asuperidea/Isaac-The-Carpentopod/README.md

# Isaac The Carpentopod

Isaac The Carpentopod is a walking robot that uses [Giliam de Carpentier's *Carpentopod* Linkage](https://www.decarpentier.nl/carpentopod). Isaac's body is fully 3D printed in PLA, his brain is an **Arduinio mega** paired with an **L298N dual motor driver** that powers both of Isaac's **Gearbox DC Motors**.

[**ASSEMBLY GUIDE**](Guide/README.md)

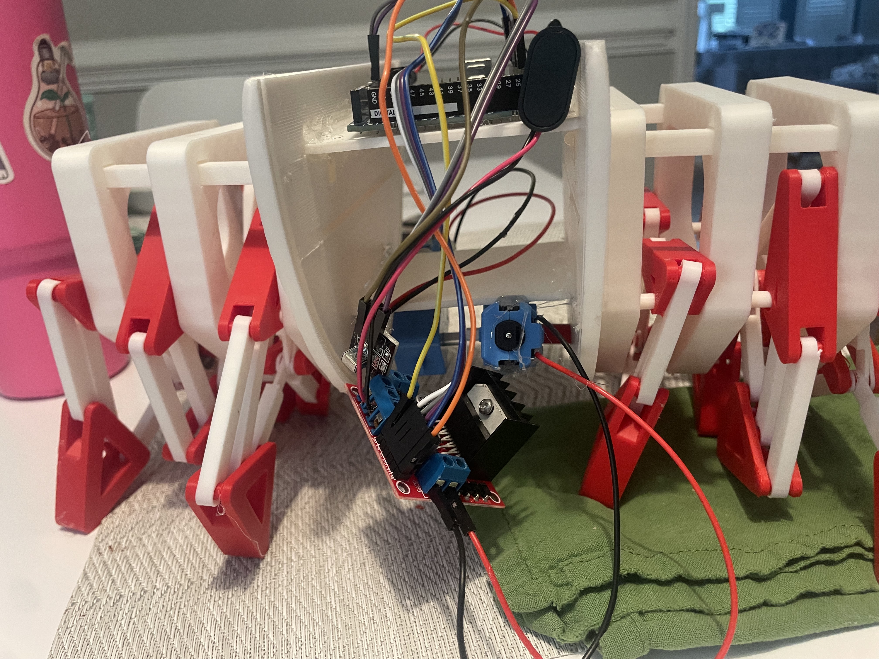
[picture p1: Images/IMG_3768.jpeg]
Image of Issac


# Story

## Design
Isaac was designed in [OnShape](https://cad.onshape.com/documents/fd8d649ce3643e24ce6086ff/w/2fd19f425c5ef16a61c62a1e/e/ff1b6042f026958810a4dbde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) using the ratios Giliam de Carpentier used in his [Walking Table](https://www.decarpentier.nl/carpentopod). These rations were generated by Giliam using software that eveloved thousands of leg generations until it found an ideal linkage. Giliam was inspried by [Jansen's linkage](https://en.wikipedia.org/wiki/Jansen%27s_linkage), a similar linkage designed by kinetic sculptor Theo Jansen for his [*Strandbeest*](https://en.wikipedia.org/wiki/Theo_Jansen#The_strandbeest).

Isaac is split into three thirds: the outer two sections house three leg linkages each, while the central section holds the electronics. The leg sections use backplates for each linkage, the backplates keep the legs in place while being attached on beams that run to the central section. The central section has four levels sandwhiched between two large plates, these levels contain the electronics.

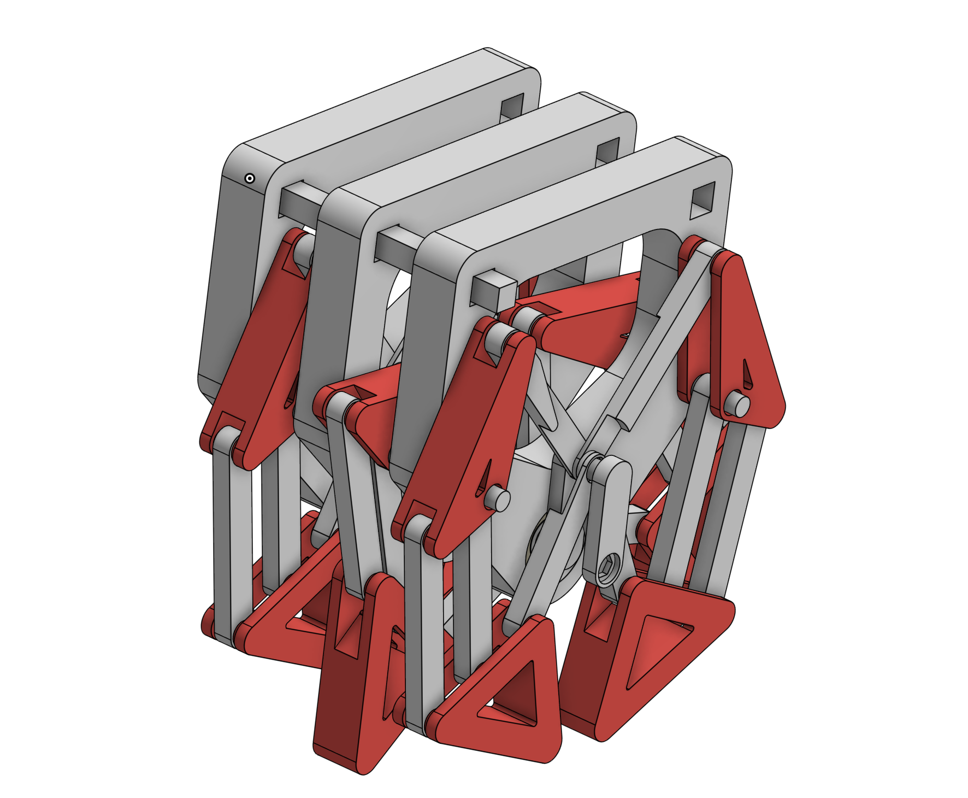
[picture p2: Images/issaclegs.png]
Isaacs Leg In Assembly

Wiring Diagram

## Printing
The 3D printing process took around 4 days of on and off printing. During this time I used an estimated 700 grams of filament (PLA). To avoid glue, I would pause prints and insert parts into them, allowing for moving parts that are still kept together. Later in the process I printed the central portions of the robot. Some parts did require [PLA glue](https://www.amazon.com/Printer-Super-Glue-Gel-Heat-Resistant/dp/B0CBSGWZRW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) to attach together. While building I also broke some parts, requiring make-up prints. ***If you would like to 3d print these parts yourself, please see the [3D Files Folder](/3D%20Files/)***.

## Building and Iteration
While Isaac was mostly built as designed, some things were changed or adapted during the process. For example I switched from hot glue to PLA glue. Another notable change was the introduction of gears to provide more torque. These changes helped make Isaac much better.

## Hackclub
Isaac was built for the [Hackclub](https://hackclub.com/) program [Macondo](https://macondo.hackclub.com/). For previous projects, Hackclub provided me with funding and an amazing community. You can see [**Isaac on Hackclub here**](https://macondo.hackclub.com/projects/7520).

Isaac was moved to [Hackclub Forge](https://forge.hackclub.com/) in October of 2026. [Isaac on Forge](https://forge.hackclub.com/projects/4168)

## Watch Isaac
See the following linsk to watch Isaac move!
- https://youtube.com/shorts/_IkzzDk3RVs 
- https://youtube.com/shorts/l0Tr8de97ck 
- https://youtube.com/shorts/lmN1PoIx2i8 
- https://youtu.be/W7OBL0XSNqM 
- https://youtube.com/shorts/VChF0OOxuyg 

# Bill of Materials
* A star Indicates somthing I already had before starting this project*

| Item | Quantity | Price | Full Price | URL | Note |
| --- | -- | ----- | --- | ---| --- |
| DC Motors | 2 | $2.50 | $9.99 (4x) | | DC Motors | 2 | $1.74 | $6.99 (4x) | https://www.amazon.com/BOJACK-Pcs-Type-130-EK1450/dp/B09FPXF1QK | Other DC motors may work |
| *Arduino MEGA | 1 | $22.99 | $22.99 | https://www.amazon.com/ELEGOO-Compatible-Arduino-Projects-Compliant/dp/B01H4ZLZLQ | Other vendors avalible |
| L298N Motor Driver | 1 | $3.45 | $6.90 | https://www.amazon.com/WWZMDiB-L298N-H-Bridge-Controller-Raspberry/dp/B0CR6BX5QL | Other vendors avalible, Only one Needed |
| *IR Remote + Reviever | 1 | $2.66 | $7.99 | https://www.amazon.com/HiLetgo-HX1838-Infrared-Wireless-Control/dp/B01HTC5JX4/ | Any Receiver/Remote that can work w/ arduino works, Only One Needed |
| *PLA Glue | 1 | $12.99 | $12.99 | https://www.amazon.com/Printer-Super-Glue-Gel-Heat-Resistant/dp/B0CBSGWZRW/ | 1.76 Oz, what I used for this project |
| Rechargeable Battieres | 2 | $3.24 | $12.99 | https://www.amazon.com/dp/B0FRMWGPD2 | 2 Minimum, 4 recomended |
| Battery Clip DC Plug | 2 | ~$2 | $3.99 | https://www.amazon.com/dp/B0D9VT2FMF | 2 Minimum, More recomended in case they break |

**See [BOM in CSV](/Misc/BOM.csv) for CSV Bill of Materials**
**See [Wiring Diagram](/Misc/Circuit%20Image%20from%20Cirkit%20Designer.svg) For Wiring**

# Repo Guide

[3D Files](/3D%20Files/) Contains all the files used here, they are also in the [OnShape](https://cad.onshape.com/documents/fd8d649ce3643e24ce6086ff/w/2fd19f425c5ef16a61c62a1e/e/35f5cd3640a624cc9189c34f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). All files are .stl with "STEPS Files" folders containing .STEP.
[Software](/Software/) Contains all the code that the arduino runs
[Journals](/Journals/) Contains every Hackclub journal entry I made (markdown files)
[Images](/Images/) Contains images of Isaac
[Guide](/Guide/) Contains BOM, Wiring, and Guide

# About Me
My name is [Simon](https://simoncrystal.dev), I am a rising 10th grader (Class of '29) in North Carolina, United States. I built Isaac to challange myself and to get into Hackclub Macondos Columbia Hackathon, an amazing oppurtunity.


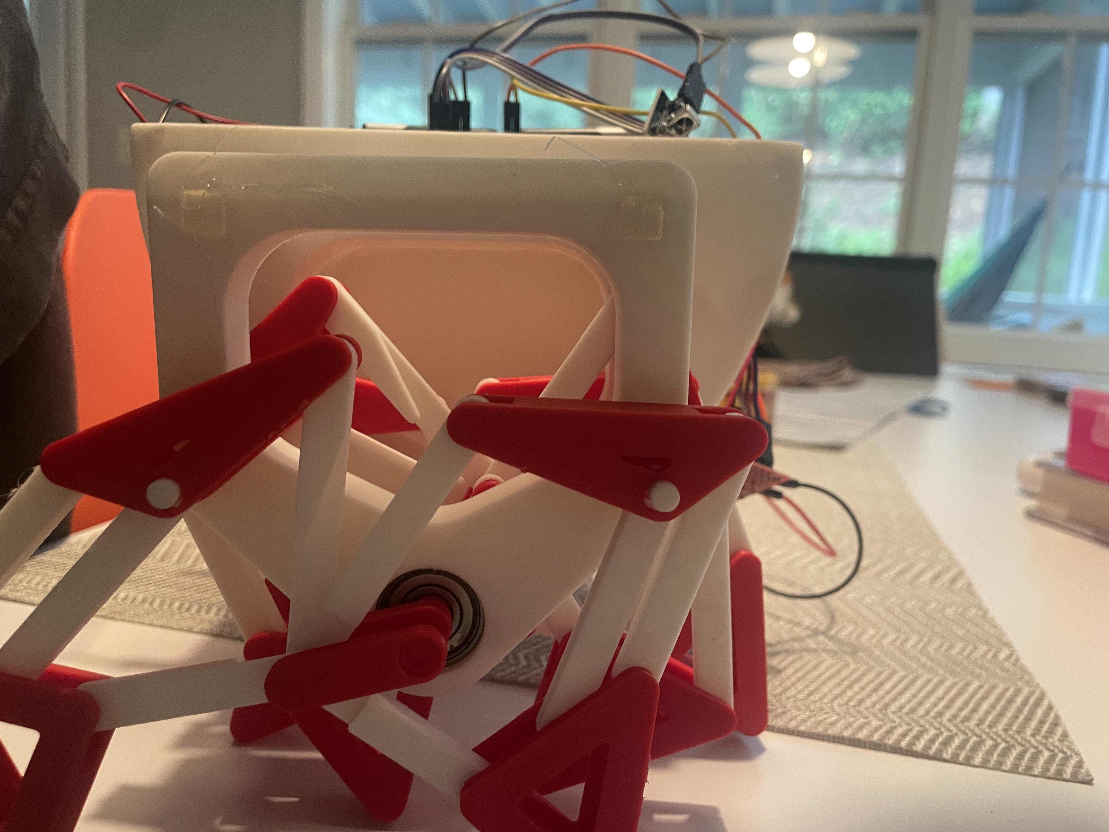
[picture p4: Images/IMG_3765.jpeg]
