asuperidea/Isaac-The-Carpentopod/Images/IMG 3727.jpg

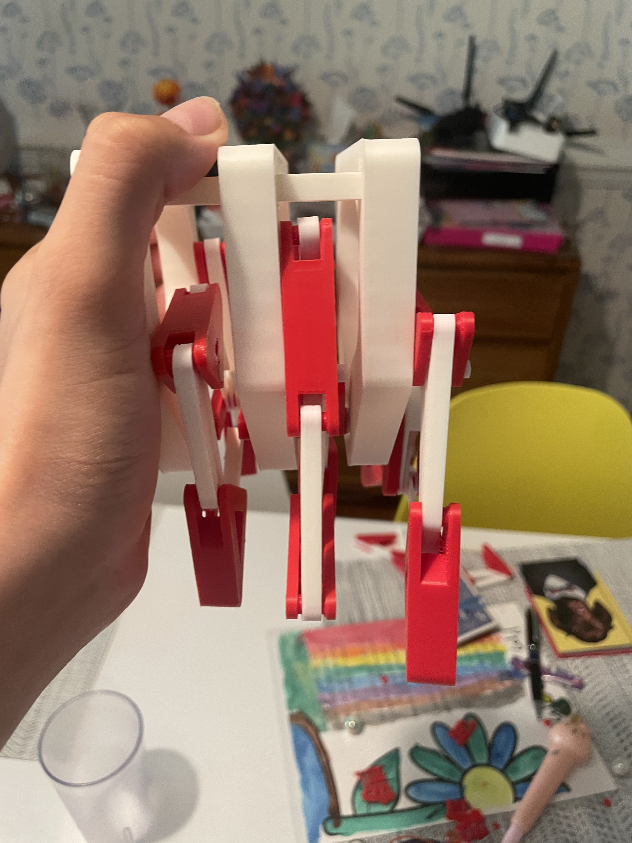
Images/IMG 3727.jpg
