asuperidea/Isaac-The-Carpentopod/Images/issacimage12.webp

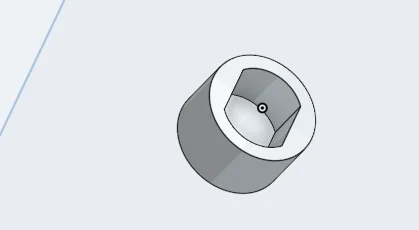
Images/issacimage12.webp
