asuperidea/Isaac-The-Carpentopod/Images/issacimage13.webp

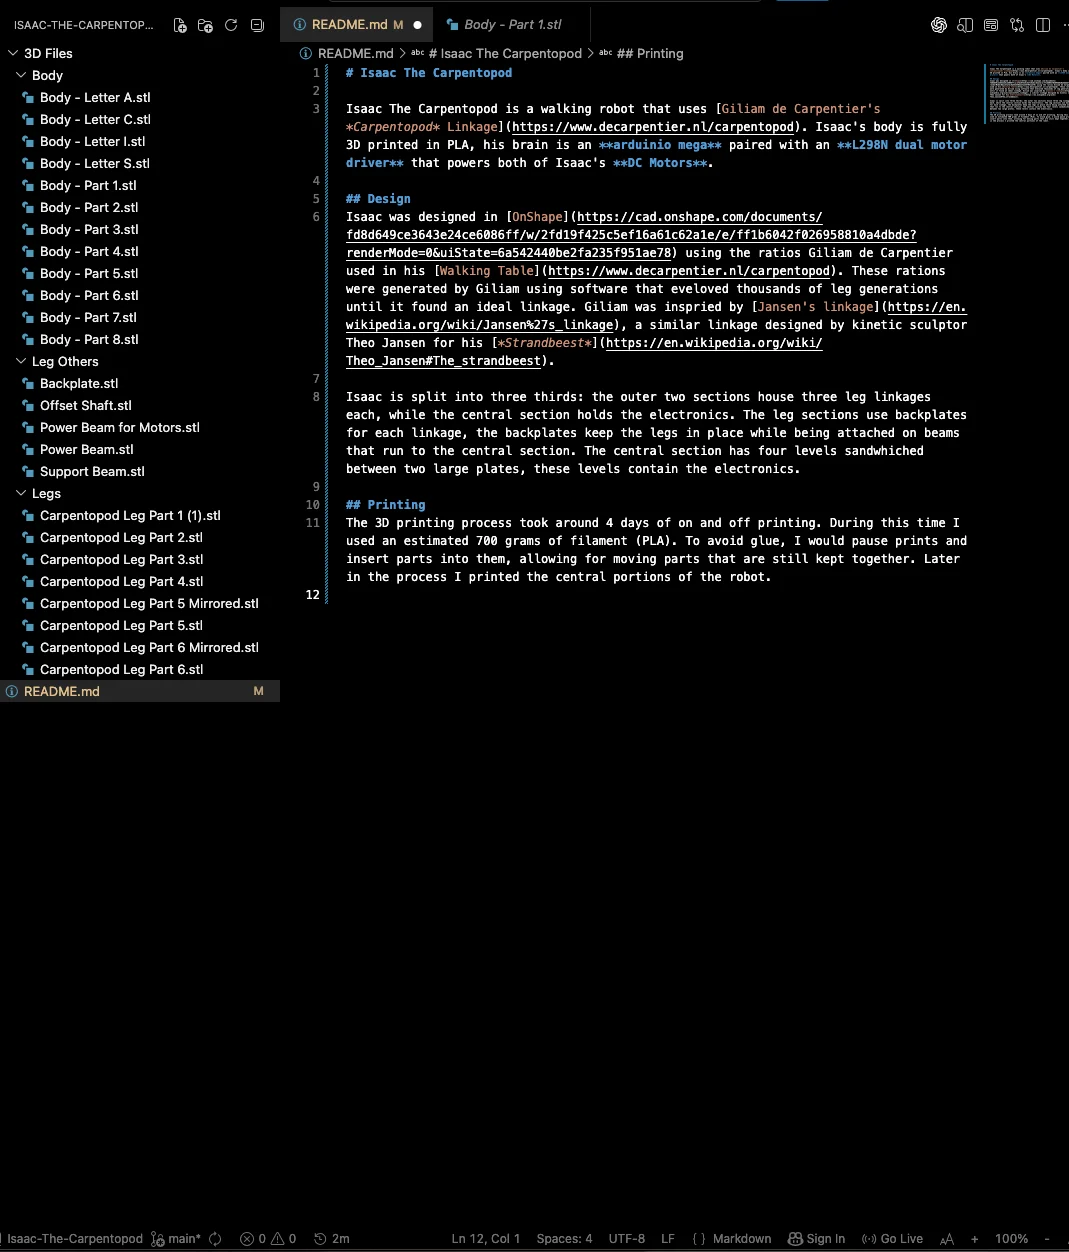
Images/issacimage13.webp
