asuperidea/Isaac-The-Carpentopod/Images/issacimage14.webp

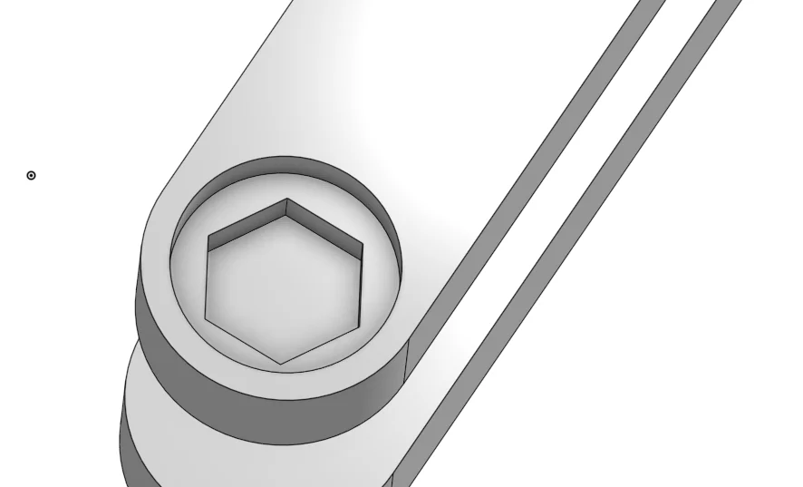
Images/issacimage14.webp
