asuperidea/Isaac-The-Carpentopod/Images/issacimage15.webp

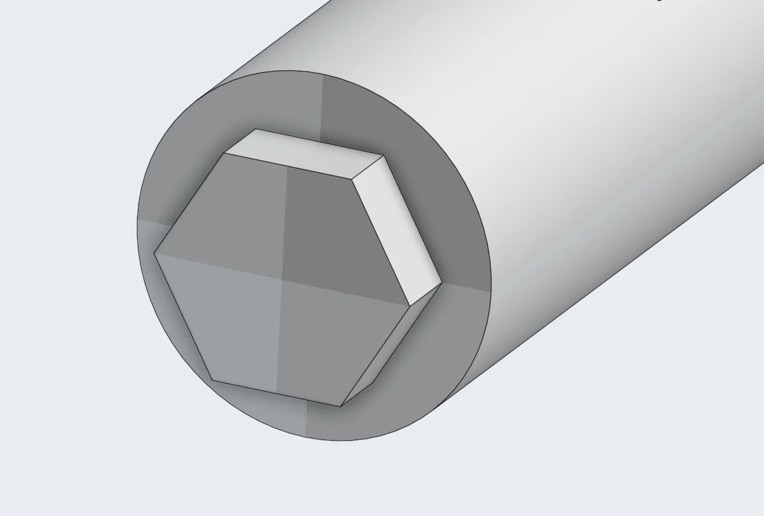
Images/issacimage15.webp
