asuperidea/Isaac-The-Carpentopod/Images/issacimage16.webp

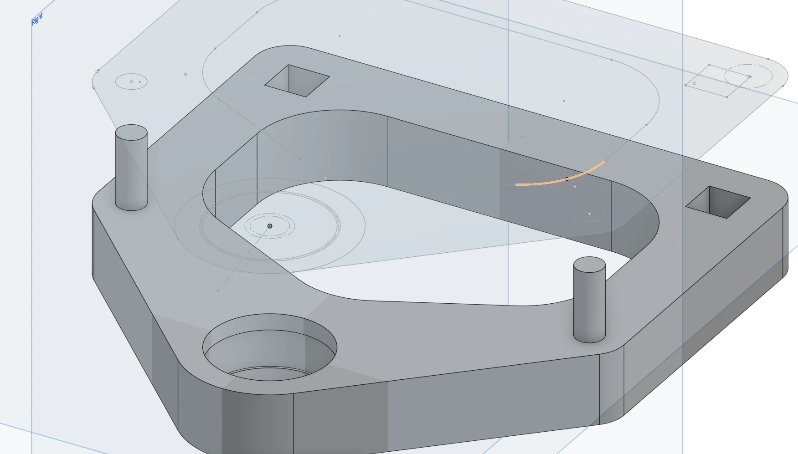
Images/issacimage16.webp
