asuperidea/Isaac-The-Carpentopod/Images/issacimage17.webp

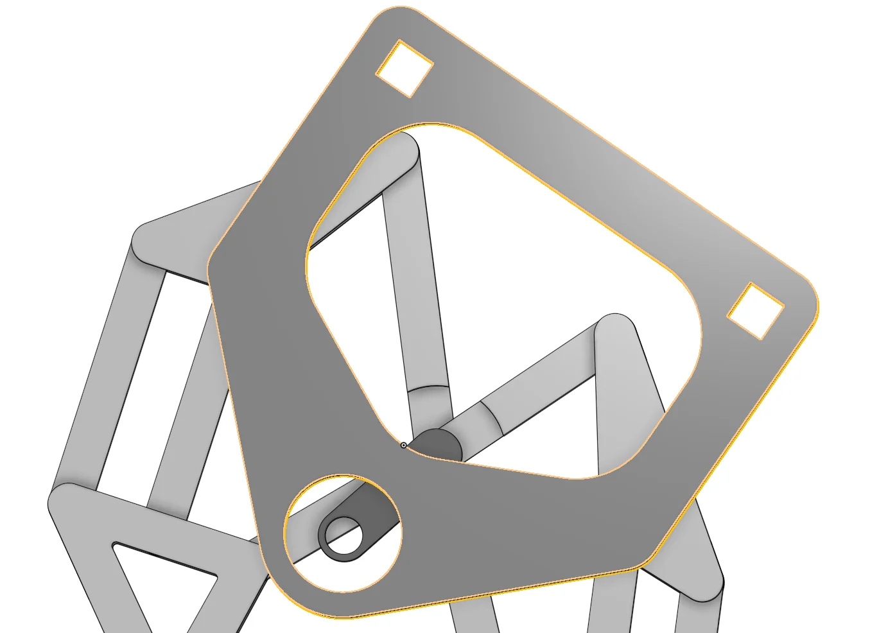
Images/issacimage17.webp
