asuperidea/Isaac-The-Carpentopod/Images/issacimage18.webp

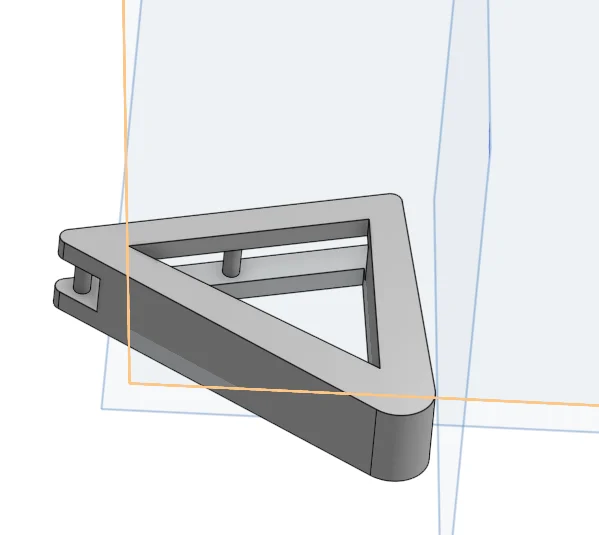
Images/issacimage18.webp
