asuperidea/Isaac-The-Carpentopod/3D Files/Assemblies/Right Leg Assembly.step

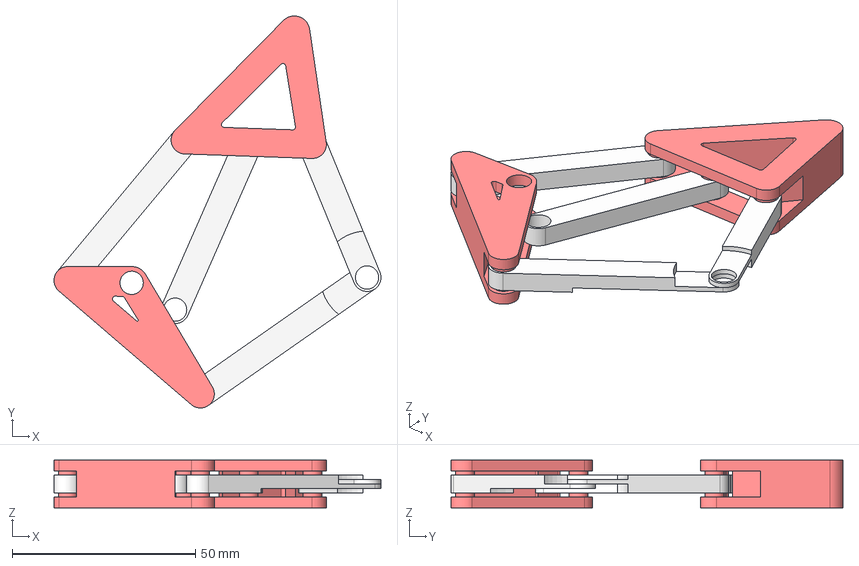
[picture p13: CAD file, 2026-10-01]
3D Files/Assemblies/Right Leg Assembly.step
89.3 x 107.0 x 13.0 mm
