asuperidea/Isaac-The-Carpentopod/3D Files/Assemblies/Left Leg Assembly.step

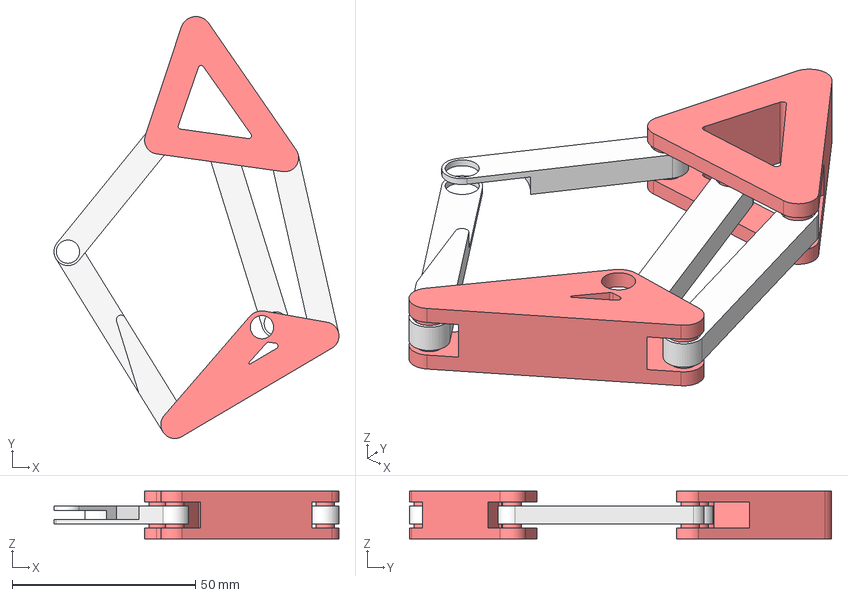
[picture p14: CAD file, 2026-10-01]
3D Files/Assemblies/Left Leg Assembly.step
77.8 x 115.2 x 13.0 mm
