asuperidea/Isaac-The-Carpentopod/3D Files/Assemblies/3x Leg Pair Assembly.step

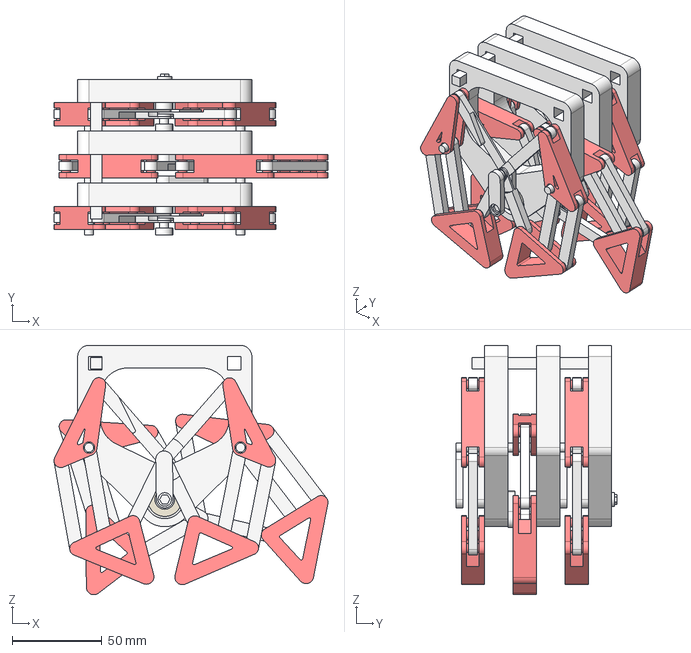
[picture p15: CAD file, 2026-10-01]
3D Files/Assemblies/3x Leg Pair Assembly.step
153.0 x 90.0 x 139.3 mm
8mm ID Bearing (22mm OD, 7mm WD, Shielded) x 3
