asuperidea/Isaac-The-Carpentopod/3D Files/Assemblies/Leg W- Backplate Assembly.step

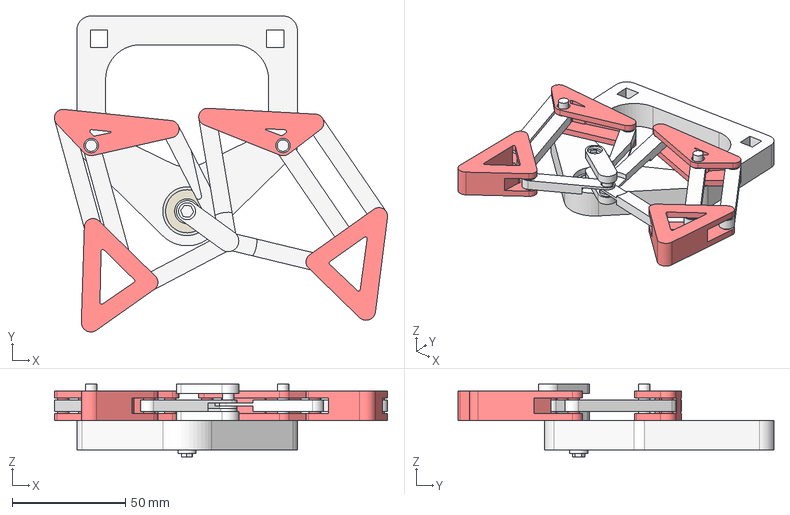
[picture p16: CAD file, 2026-10-01]
3D Files/Assemblies/Leg W- Backplate Assembly.step
146.9 x 139.4 x 32.0 mm
8mm ID Bearing (22mm OD, 7mm WD, Shielded)
