asuperidea/Isaac-The-Carpentopod/3D Files/Body/Basic Body/STEP Files/Body - Main Plate.step

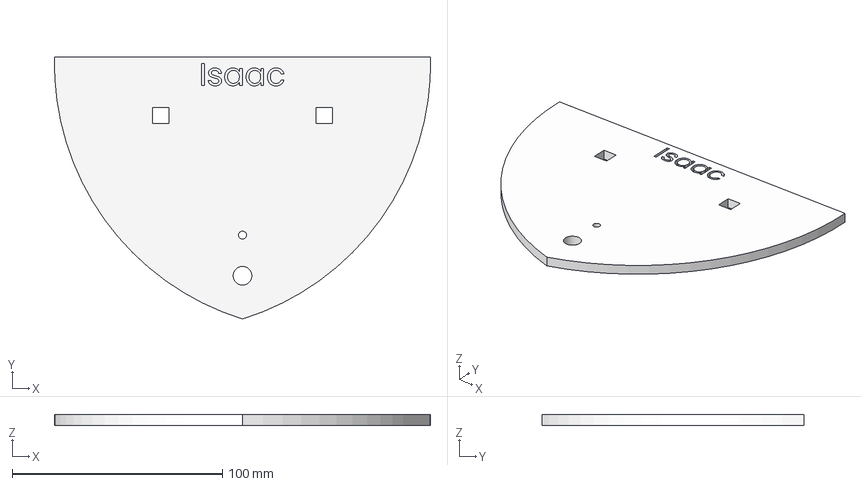
[picture p17: CAD file, 2026-08-03]
3D Files/Body/Basic Body/STEP Files/Body - Main Plate.step
178.7 x 124.5 x 5.00 mm
