asuperidea/Isaac-The-Carpentopod/3D Files/Body/Basic Body/STEP Files/Body - Part 5.step

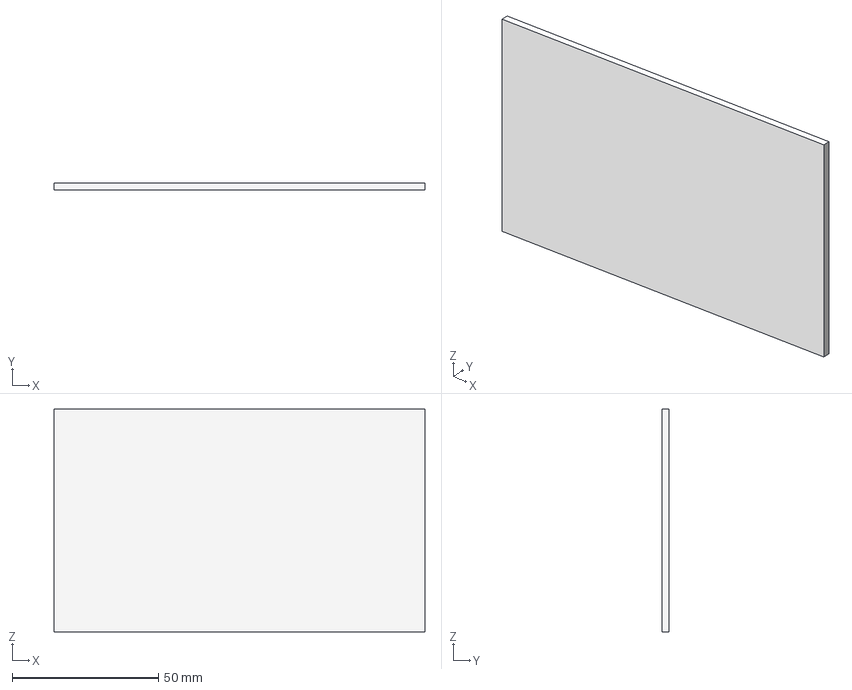
[picture p18: CAD file, 2026-08-03]
3D Files/Body/Basic Body/STEP Files/Body - Part 5.step
127.0 x 2.54 x 76.2 mm
