asuperidea/Isaac-The-Carpentopod/3D Files/Body/Gears/Body - Spur gear (8 teeth).stl

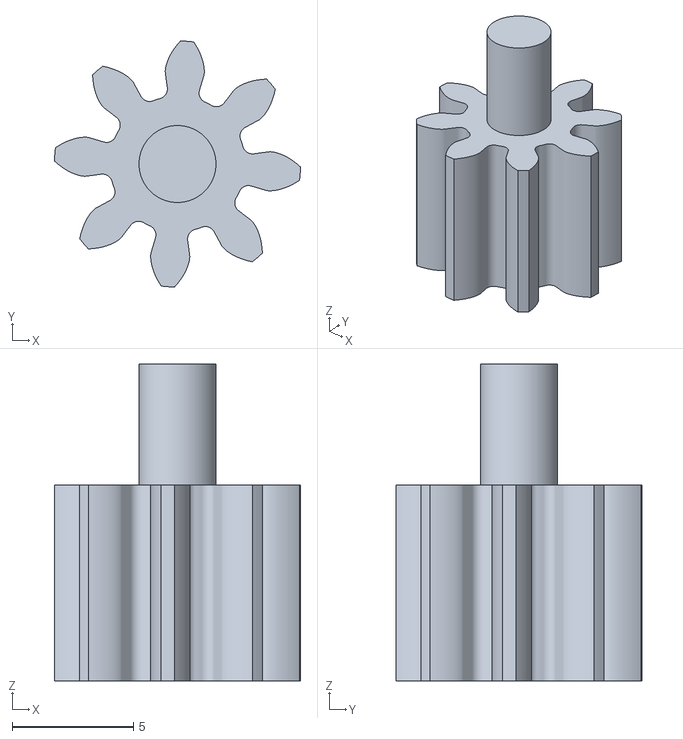
[picture p19: CAD file, 2026-08-02]
3D Files/Body/Gears/Body - Spur gear (8 teeth).stl
10.2 x 10.2 x 13.1
