asuperidea/Isaac-The-Carpentopod/3D Files/Body/Letters/STEP Files/Body - Letter S.step

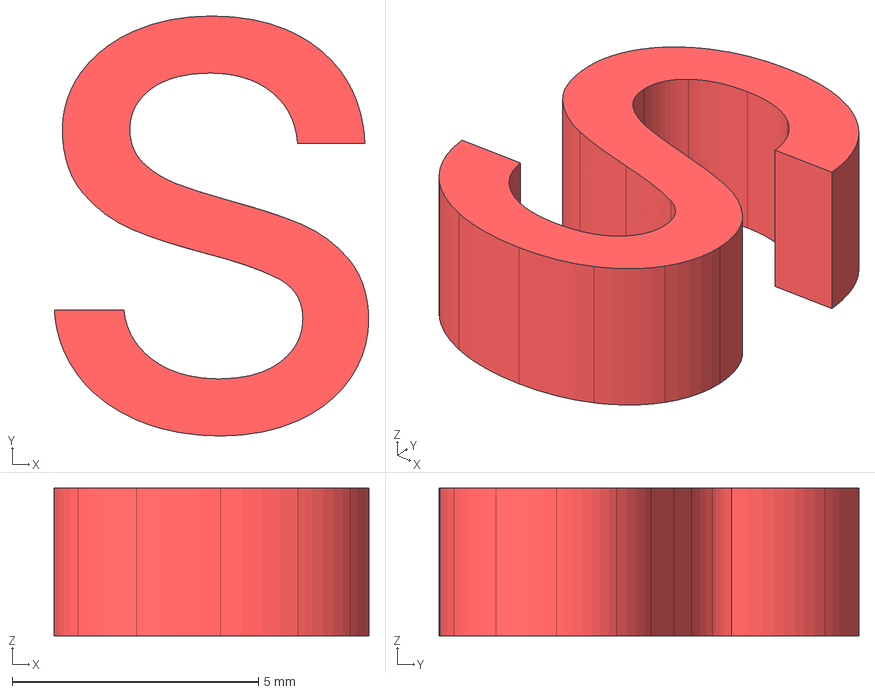
[picture p20: CAD file, 2026-08-03]
3D Files/Body/Letters/STEP Files/Body - Letter S.step
6.38 x 8.52 x 3.00 mm
