asuperidea/Isaac-The-Carpentopod/3D Files/Leg Others/STEP Files/Power Beam for Motors.step

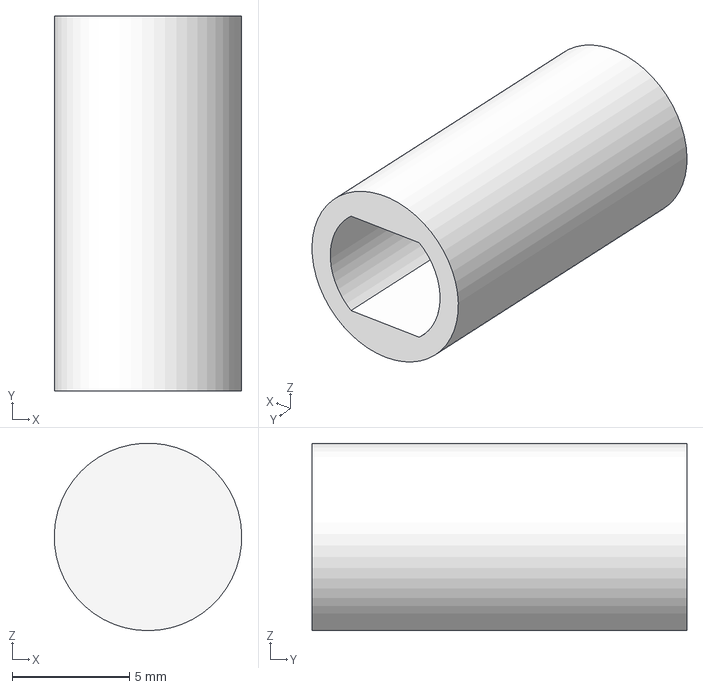
[picture p21: CAD file, 2026-08-03]
3D Files/Leg Others/STEP Files/Power Beam for Motors.step
8.00 x 16.0 x 7.99 mm
