asuperidea/Isaac-The-Carpentopod/3D Files/Legs/Carpentopod Leg Part 5 Mirrored.stl

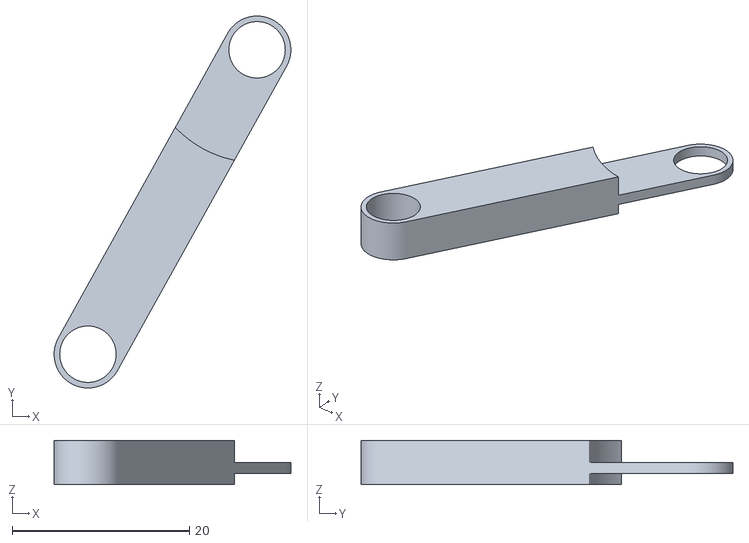
[picture p22: CAD file, 2026-06-21]
3D Files/Legs/Carpentopod Leg Part 5 Mirrored.stl
26.7 x 41.9 x 5.00
