asuperidea/Isaac-The-Carpentopod/3D Files/Legs/STEP Files/Leg Part 1.step

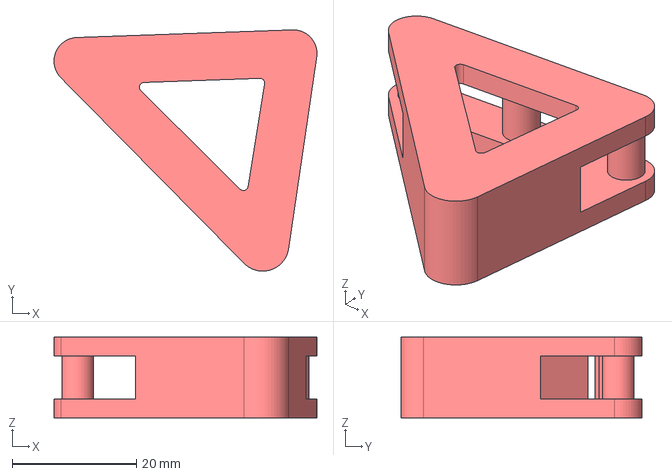
[picture p23: CAD file, 2026-08-03]
3D Files/Legs/STEP Files/Leg Part 1.step
42.4 x 38.9 x 13.0 mm
