asuperidea/Isaac-The-Carpentopod/3D Files/Body/Basic Body/Body - Part 6.stl

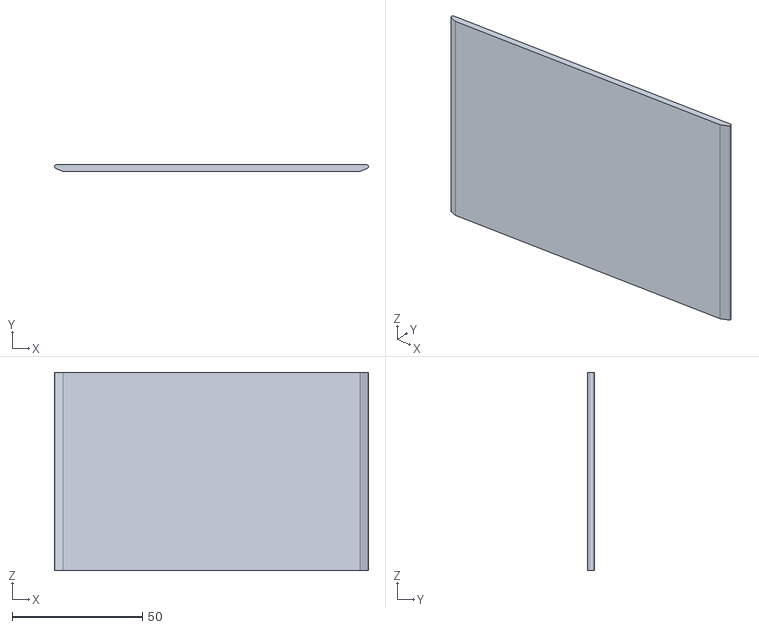
[picture p24: CAD file, 2026-07-01]
3D Files/Body/Basic Body/Body - Part 6.stl
120.6 x 2.54 x 76.2
