asuperidea/Isaac-The-Carpentopod/3D Files/Body/Gears/Body - Spur gear (30 teeth).stl

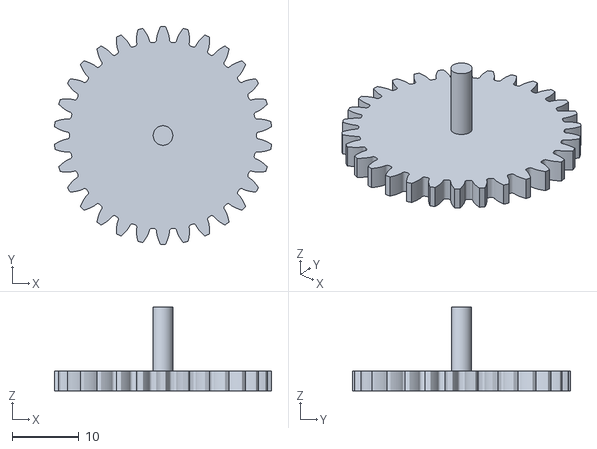
[picture p25: CAD file, 2026-08-02]
3D Files/Body/Gears/Body - Spur gear (30 teeth).stl
32.4 x 32.5 x 12.5
