asuperidea/Isaac-The-Carpentopod/3D Files/Body/Letters/STEP Files/Body - Letter I.step

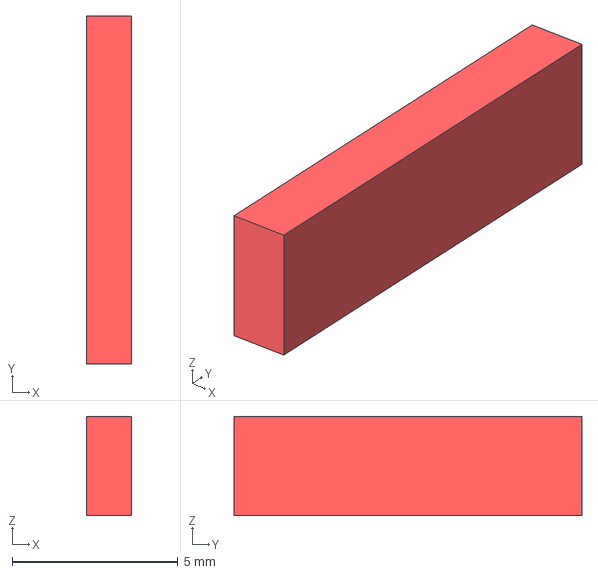
[picture p26: CAD file, 2026-08-03]
3D Files/Body/Letters/STEP Files/Body - Letter I.step
1.37 x 10.5 x 3.00 mm
