asuperidea/Isaac-The-Carpentopod/3D Files/Leg Others/STEP Files/Power Beam.step

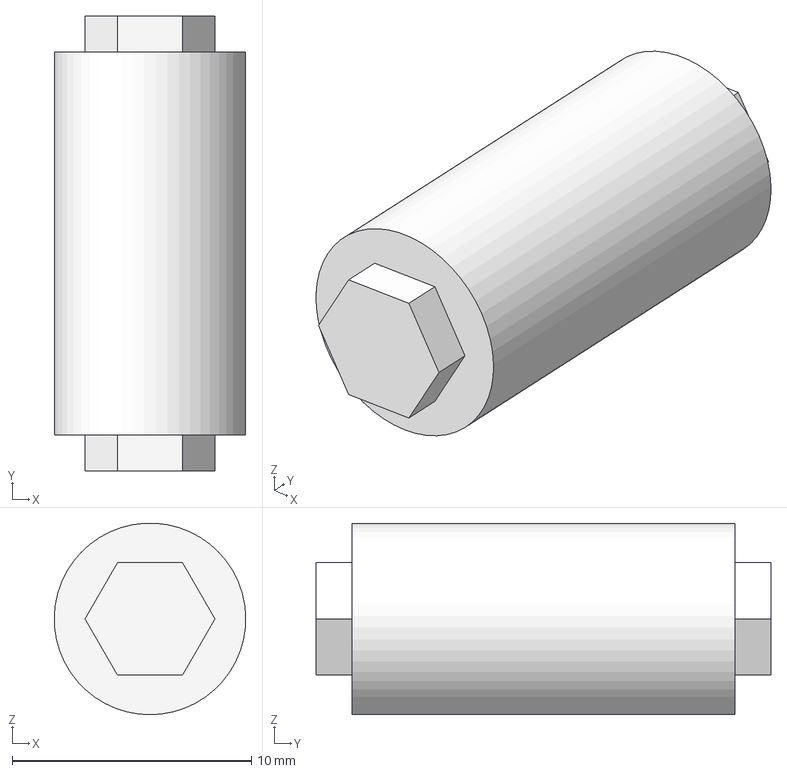
[picture p27: CAD file, 2026-08-03]
3D Files/Leg Others/STEP Files/Power Beam.step
8.00 x 19.0 x 7.99 mm
