asuperidea/Isaac-The-Carpentopod/3D Files/Legs/Carpentopod Leg Part 4.stl

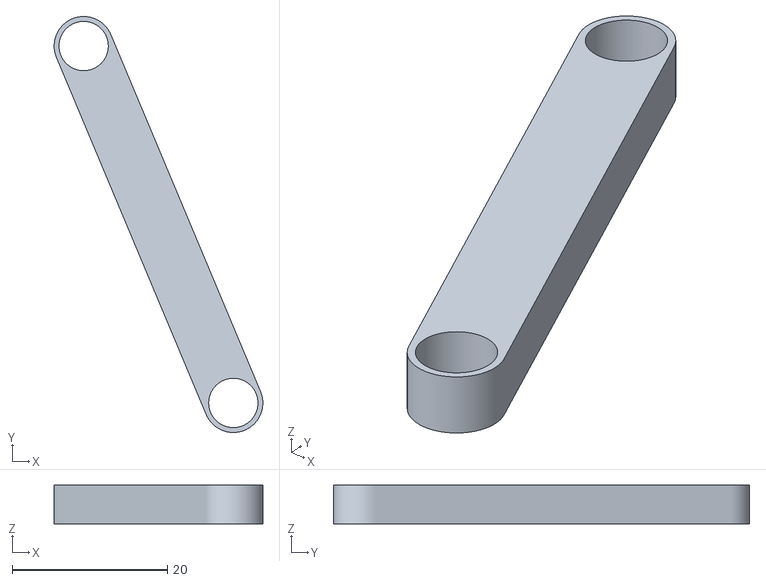
[picture p28: CAD file, 2026-06-21]
3D Files/Legs/Carpentopod Leg Part 4.stl
26.9 x 53.6 x 5.00
