asuperidea/Isaac-The-Carpentopod/3D Files/Body/Basic Body/Body - Part 3.stl

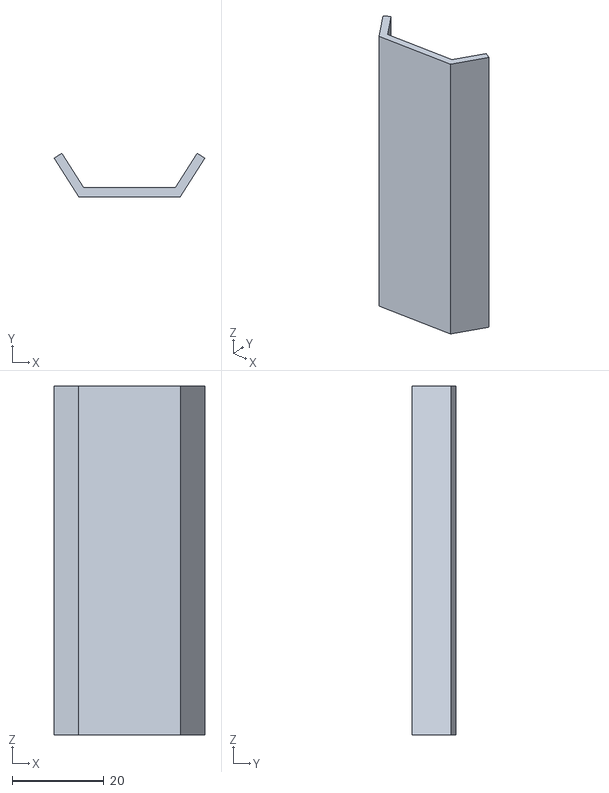
[picture p29: CAD file, 2026-07-01]
3D Files/Body/Basic Body/Body - Part 3.stl
32.9 x 9.50 x 76.2
