asuperidea/Isaac-The-Carpentopod/3D Files/Body/Basic Body/STEP Files/Body - Part 4.step

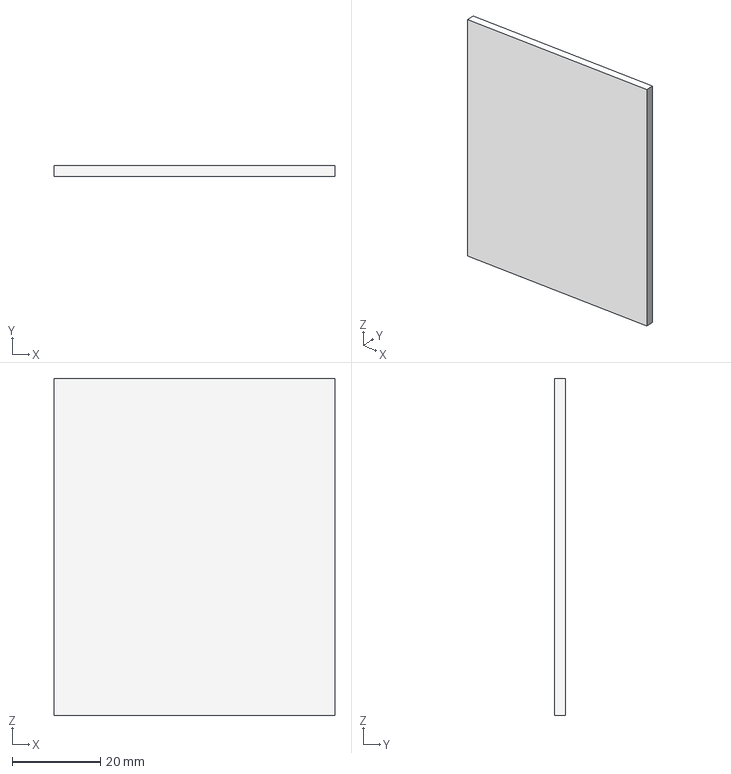
[picture p30: CAD file, 2026-08-03]
3D Files/Body/Basic Body/STEP Files/Body - Part 4.step
63.5 x 2.54 x 76.2 mm
