asuperidea/Isaac-The-Carpentopod/3D Files/Body/Letters/STEP Files/Body - Letter C.step

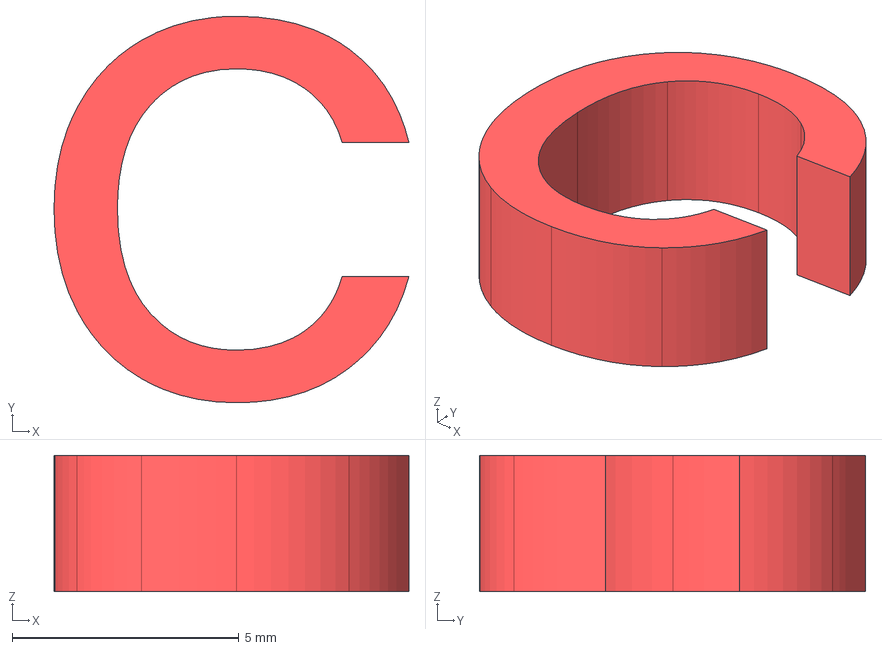
[picture p31: CAD file, 2026-08-03]
3D Files/Body/Letters/STEP Files/Body - Letter C.step
7.83 x 8.52 x 3.00 mm
