asuperidea/Isaac-The-Carpentopod/3D Files/Leg Others/STEP Files/Offset Shaft.step

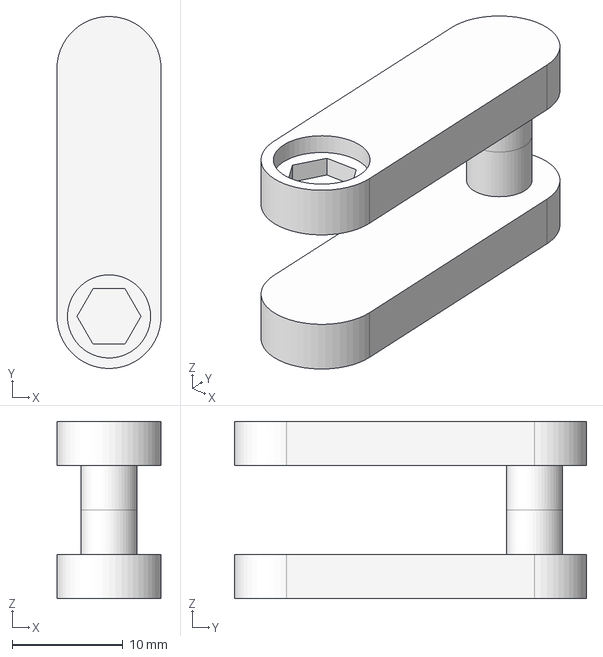
[picture p32: CAD file, 2026-08-03]
3D Files/Leg Others/STEP Files/Offset Shaft.step
9.40 x 31.8 x 16.0 mm
