asuperidea/Isaac-The-Carpentopod/3D Files/Legs/Carpentopod Leg Part 6 Mirrored.stl

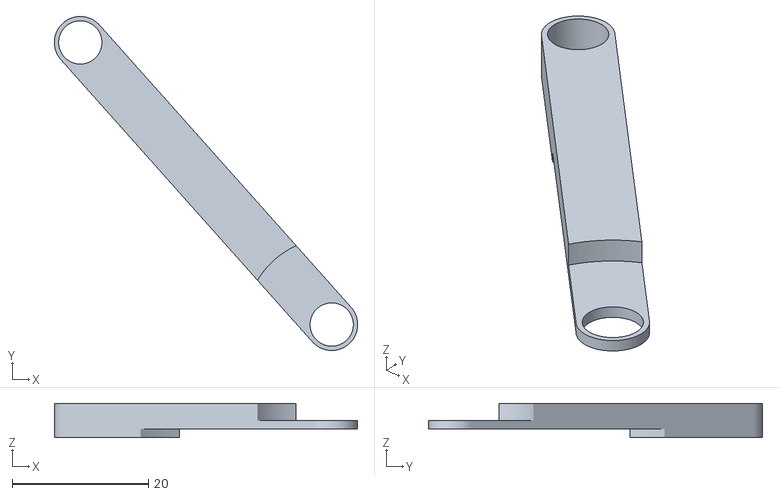
[picture p33: CAD file, 2026-06-21]
3D Files/Legs/Carpentopod Leg Part 6 Mirrored.stl
44.5 x 49.0 x 5.00
