asuperidea/Isaac-The-Carpentopod/3D Files/Body/Letters/STEP Files/Body - Letter A.step

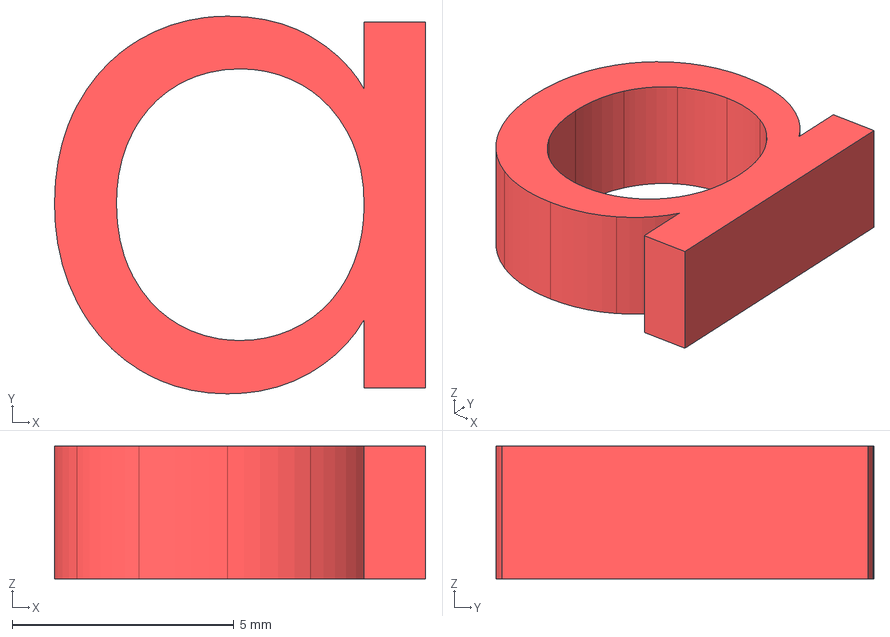
[picture p34: CAD file, 2026-08-03]
3D Files/Body/Letters/STEP Files/Body - Letter A.step
8.37 x 8.52 x 3.00 mm
