asuperidea/Isaac-The-Carpentopod/3D Files/Leg Others/STEP Files/Support Beam.step

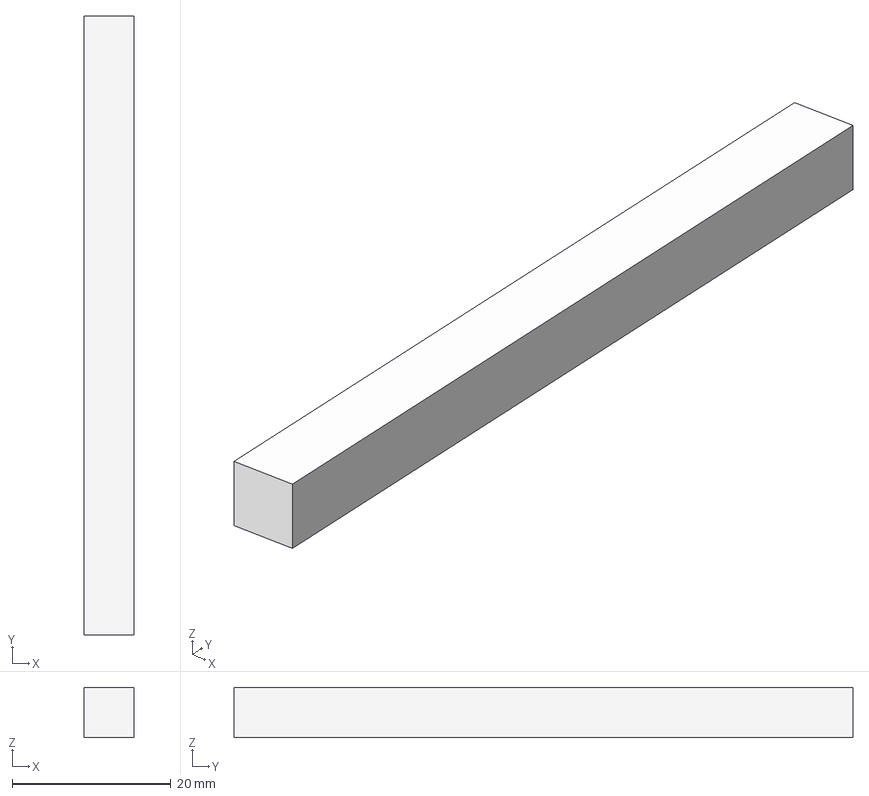
[picture p35: CAD file, 2026-08-03]
3D Files/Leg Others/STEP Files/Support Beam.step
6.35 x 78.0 x 6.35 mm
