asuperidea/Isaac-The-Carpentopod/3D Files/Legs/Carpentopod Leg Part 2.stl

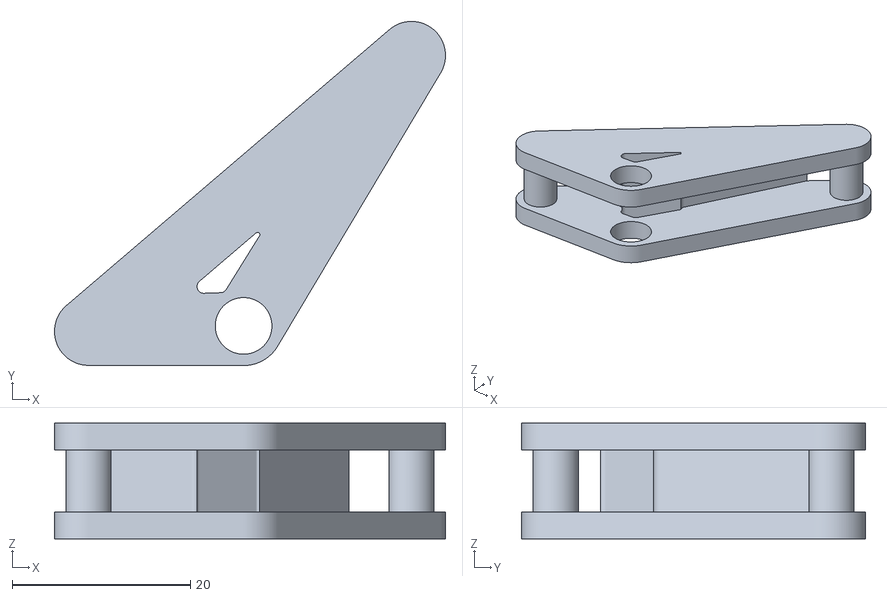
[picture p36: CAD file, 2026-06-21]
3D Files/Legs/Carpentopod Leg Part 2.stl
43.8 x 38.6 x 13.0
