asuperidea/Isaac-The-Carpentopod/3D Files/Leg Others/STEP Files/Backplate.step

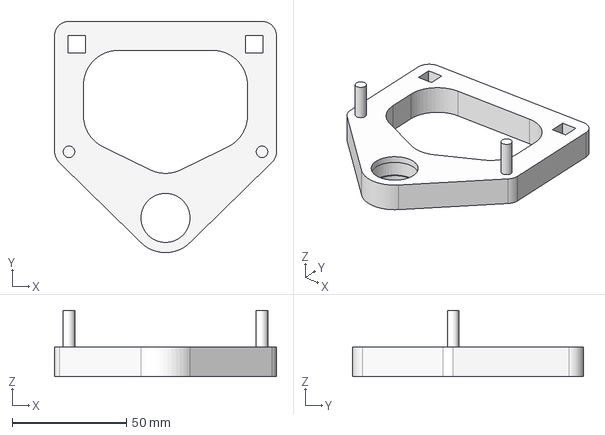
[picture p37: CAD file, 2026-08-03]
3D Files/Leg Others/STEP Files/Backplate.step
97.3 x 101.3 x 29.0 mm
