asuperidea/Isaac-The-Carpentopod/(list of files, cad)

Other CAD files:
3D Files/Legs/STEP Files/Leg Part 5.step
3D Files/Legs/STEP Files/Leg Part 3:4.step
3D Files/Legs/STEP Files/Leg Part 6 Mirrored.step
3D Files/Legs/Carpentopod Leg Part 1 (1).stl
3D Files/Legs/STEP Files/Leg Part 6.step
3D Files/Legs/Carpentopod Leg Part 3.stl
3D Files/Legs/STEP Files/Leg Part 5 Mirrored.step
3D Files/Legs/Carpentopod Leg Part 5.stl
3D Files/Legs/STEP Files/Leg Part 2.step
3D Files/Legs/Carpentopod Leg Part 6.stl
3D Files/Body/Basic Body/Body - Part 4.stl
3D Files/Body/Basic Body/Body - Part 5.stl
3D Files/Body/Basic Body/Body Main Plate.stl
3D Files/Body/Basic Body/STEP Files/[Unused] Body - Part 6.step
3D Files/Body/Letters/Body - Letter A.stl
3D Files/Body/Letters/Body - Letter C.stl
3D Files/Body/Letters/Body - Letter I.stl
3D Files/Body/Letters/Body - Letter S.stl
3D Files/Body/[Unused In Final Design]Gears/Body - Spur gear (30 teeth).step
3D Files/Body/[Unused In Final Design]Gears/Body - Spur gear (8 teeth).step
3D Files/Leg Others/Backplate.stl
3D Files/Leg Others/Offset Shaft.stl
3D Files/Leg Others/Power Beam for Motors.stl
3D Files/Leg Others/Power Beam.stl
3D Files/Leg Others/Support Beam.stl
