asuperidea/Isaac-The-Carpentopod/(commit log)

2026-06-21 added leg stl s
    [Carpentopod Leg Part 1 (1).stl, Carpentopod Leg Part 2.stl, Carpentopod Leg Part 3.stl, Carpentopod Leg Part 4.stl, Carpentopod Leg Part 5 Mirrored.stl, Carpentopod Leg Part 5.stl, Carpentopod Leg Part 6 Mirrored.stl, Carpentopod Leg Part 6.stl]
2026-07-01 Added 3D Files for The Legs Backplate Rotational Parts The Body / The Center
    [Backplate.stl, Body - Letter A.stl, Body - Letter C.stl, Body - Letter I.stl, Body - Letter S.stl, Body - Part 1.stl, Body - Part 2.stl, Body - Part 3.stl]
2026-08-02 V1 Commit
    [Body - Letter A.stl, Body - Letter C.stl, Body - Letter I.stl, Body - Letter S.stl, Body - Part 1.stl, Body - Part 2.stl, Body - Part 3.stl, Body - Part 4.stl]
2026-08-03 Added STEP Files, Removed unused Files
    [BOM.csv, Backplate.step, Body - Letter A.step, Body - Letter C.step, Body - Letter I.step, Body - Letter S.step, Body - Main Plate.step, Body - Part 4.step]
2026-08-03 Added Wiring Diagram
2026-10-01 Assembly STEPS
    [3x Leg Pair Assembly.step, Left Leg Assembly.step, Leg W- Backplate Assembly.step, Right Leg Assembly.step]
2026-10-01 Added assembly image
2026-10-31 wiring diagram
2026-10-31 Rename Circuit Image from Cirkit Designer.svg to wiring_diagram
2026-10-31 Add wiring diagram SVG file
2026-10-31 wiring diagram in images
2026-10-31 Add wiring diagram to README
    Added a wiring diagram image to the README.
2026-10-31 Update JOURNAL with Day 27 entry
    Added wiring diagram to README despite existing in /misc folder.
2026-10-31 Update Day 27 entry with wiring diagram
    Added wiring diagram to the journal entry.
2026-11-06 Fix formatting of assembly guide link in README
2026-11-06 Update JOURNAL with Day 29 entry
    Added a new entry for Day 29 regarding repo visibility and linked the assembly guide in the README.
