asuperidea/Isaac-The-Carpentopod/Images/IMG_3763.jpeg

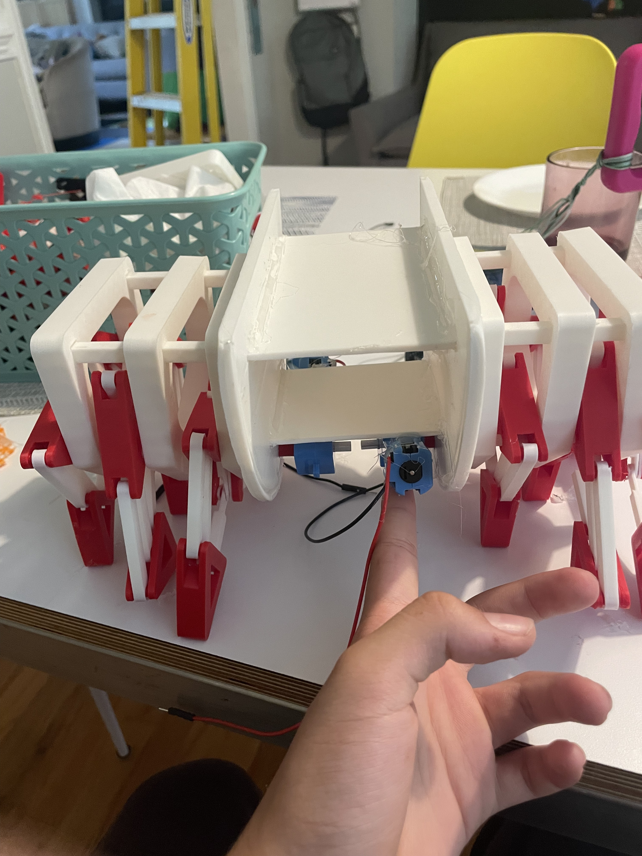
[picture p38: Images/IMG_3763.jpeg]
Images/IMG_3763.jpeg
