asuperidea/Isaac-The-Carpentopod/Images/IMG_3764.jpeg

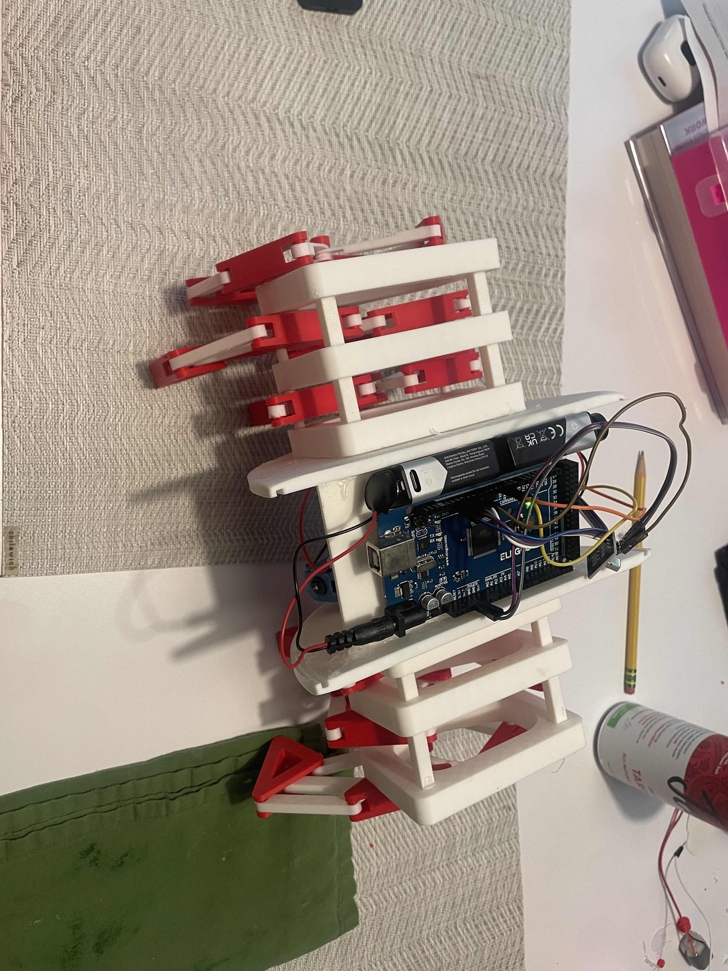
[picture p49: Images/IMG_3764.jpeg]
Images/IMG_3764.jpeg
