asuperidea/Isaac-The-Carpentopod/Images/IMG_3767.jpeg

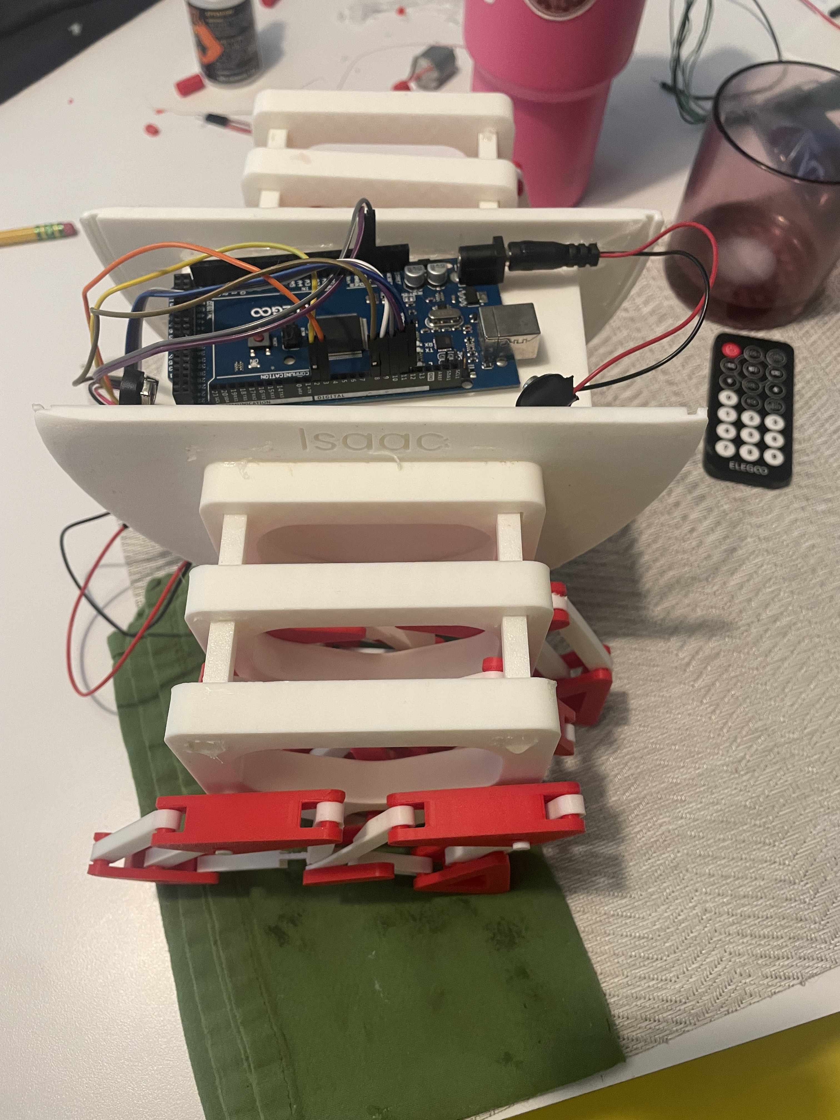
[picture p3: Images/IMG_3767.jpeg]
Images/IMG_3767.jpeg
